ra0sms/civ2bcd/docs/pinout_v003f4.png

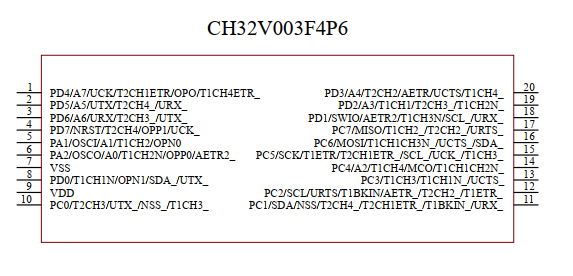
docs/pinout_v003f4.png
