ra0sms/civ2bcd/KiCad/civ2bcd/civ2bcd.pdf

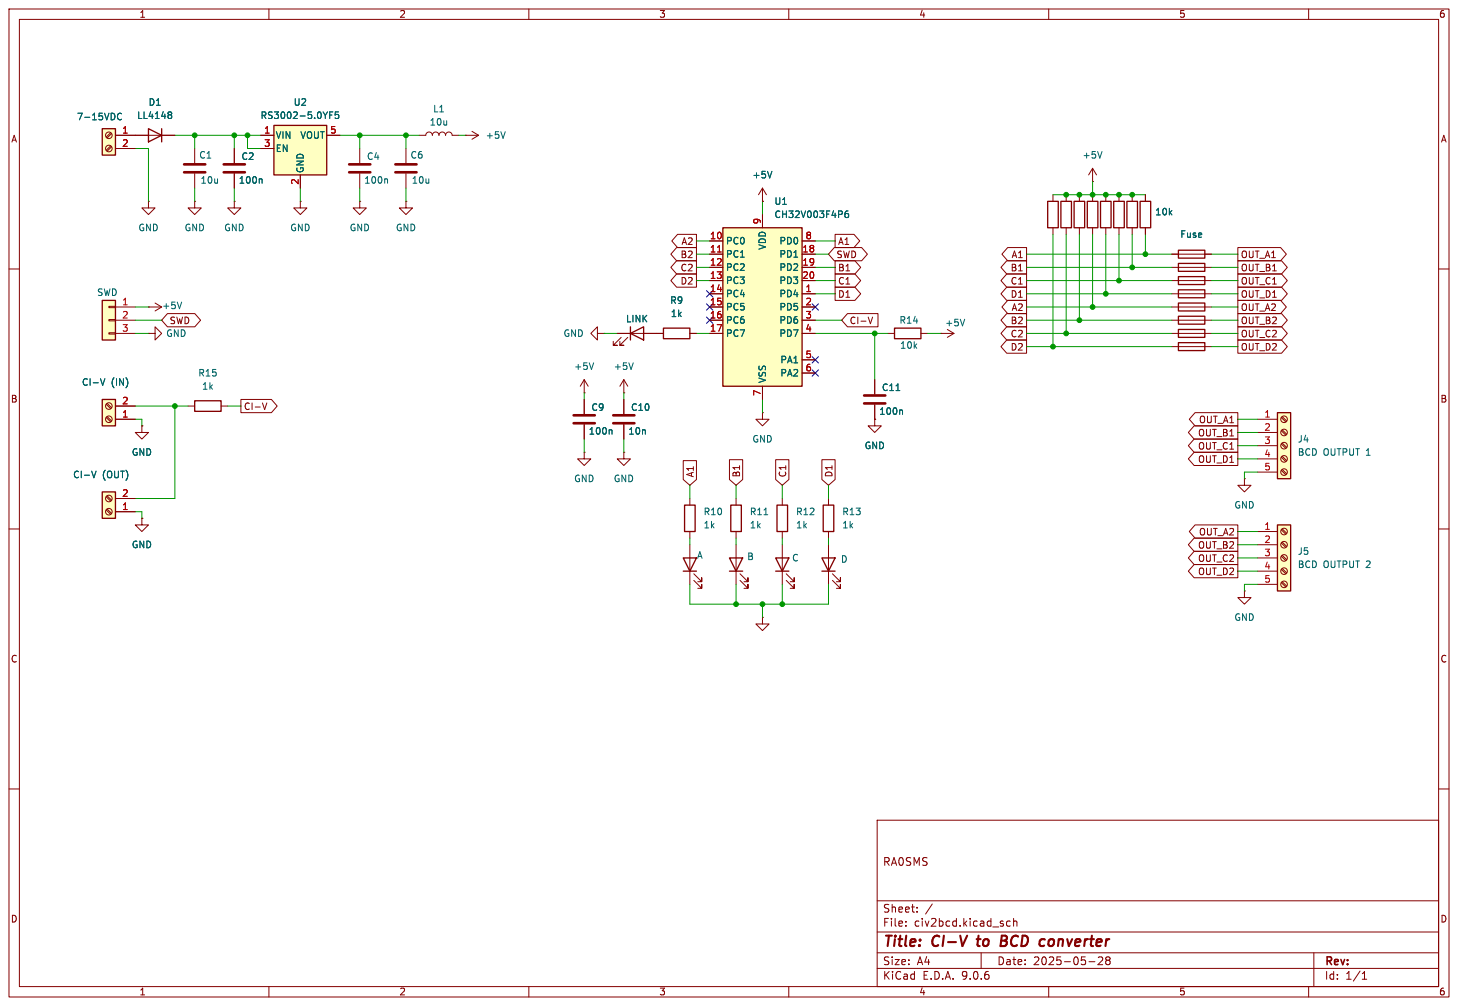
[picture p4: page 1]

Id: 1/1 Title: CI-V to BCD converter File: civ2bcd.kicad_sch Sheet: / RA0SMS
