ra0sms/civ2bcd/KiCad/civ2bcd/civ2bcd.kicad_pcb

## KiCad design KiCad/civ2bcd/civ2bcd.kicad_pcb (2026-01-14)

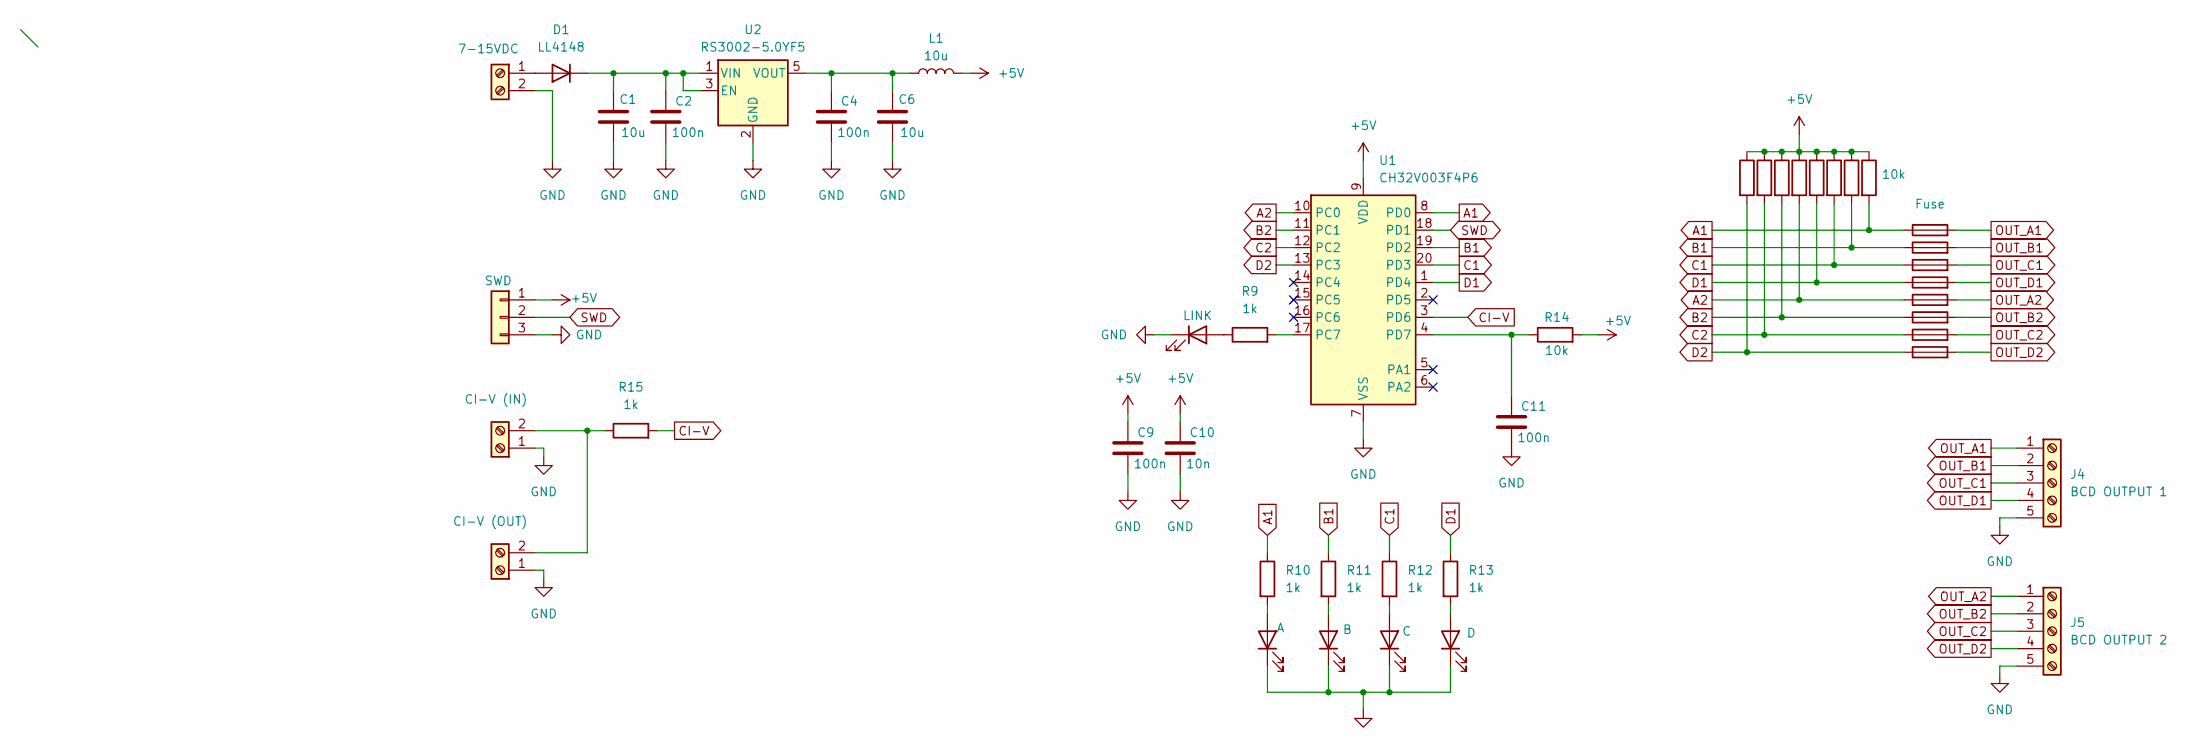
[picture p5: schematic civ2bcd.kicad_sch, CI-V to BCD converter]

Parts:
C1, C6: 10u; C_1206_3216Metric_Pad1.33x1.80mm_HandSolder
C2, C4, C9, C11: 100n; C_1206_3216Metric_Pad1.33x1.80mm_HandSolder
C10: 10n; C_1206_3216Metric_Pad1.33x1.80mm_HandSolder
D1: LL4148; D_MiniMELF
D2: LINK; LED_1206_3216Metric
D3: A; LED_1206_3216Metric
D4: B; LED_1206_3216Metric
D5: C; LED_1206_3216Metric
D6: D; LED_1206_3216Metric
F1, F2, F3, F4, F5, F6, F7, F8: Fuse; R_1206_3216Metric
J1: 7-15VDC; TerminalBlock_MetzConnect_Type055_RT01502HDWU_1x02_P5.00mm_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
J2: CI-V (OUT); TerminalBlock_MetzConnect_Type055_RT01502HDWU_1x02_P5.00mm_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
J3: SWD; PinSocket_1x03_P2.54mm_Vertical
J4: BCD OUTPUT 1; TerminalBlock_MetzConnect_Type011_RT05505HBLC_1x05_P5.00mm_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
J5: BCD OUTPUT 2; TerminalBlock_MetzConnect_Type011_RT05505HBLC_1x05_P5.00mm_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
J6: CI-V (IN); TerminalBlock_MetzConnect_Type055_RT01502HDWU_1x02_P5.00mm_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
L1: 10u; L_1206_3216Metric
R5, R6, R7, R8, R14, R19, R20, R21, R22: 10k; R_1206_3216Metric
R9, R10, R11, R12, R13, R15: 1k; R_1206_3216Metric
U1: CH32V003F4P6; TSSOP-20_4.4x6.5mm_P0.65mm
U2: RS3002-5.0YF5; SOT-23-5

Connections:
+5V: C9.1, C10.1, J3.1, L1.2, R5.1, R6.1, R7.1, R8.1, R14.2, R19.1, R20.1, R21.1, R22.1, U1.9 (VDD)
A1: F1.1, R5.2, R10.1, U1.8 (PD0)
A2: F5.1, R19.2, U1.10 (PC0)
B1: F2.1, R6.2, R11.1, U1.19 (PD2)
B2: F6.1, R20.2, U1.11 (PC1)
C1: F3.1, R7.2, R12.1, U1.20 (PD3)
C2: F7.1, R21.2, U1.12 (PC2)
CI-V: R15.2, U1.3 (PD6)
D1: F4.1, R8.2, R13.1, U1.1 (PD4)
D2: F8.1, R22.2, U1.13 (PC3)
GND: C1.2, C2.2, C4.2, C6.2, C9.2, C10.2, C11.2, D2.1 (K), D3.1 (K), D4.1 (K), D5.1 (K), D6.1 (K), J1.2, J2.1, J3.3, J4.5, J5.5, J6.1, U1.7 (VSS), U2.2 (GND)
unnamed: D1.2 (A), J1.1
unnamed: C1.1, C2.1, D1.1 (K), U2.1 (VIN), U2.3 (EN)
unnamed: D2.2 (A), R9.1
unnamed: D3.2 (A), R10.2
unnamed: D4.2 (A), R11.2
unnamed: D5.2 (A), R12.2
unnamed: D6.2 (A), R13.2
unnamed: J2.2, J6.2, R15.1
unnamed: R9.2, U1.17 (PC7)
unnamed: C11.1, R14.1, U1.4 (PD7)
unnamed: C4.1, C6.1, L1.1, U2.5 (VOUT)
OUT_A1: F1.2, J4.1
OUT_A2: F5.2, J5.1
OUT_B1: F2.2, J4.2
OUT_B2: F6.2, J5.2
OUT_C1: F3.2, J4.3
OUT_C2: F7.2, J5.3
OUT_D1: F4.2, J4.4
OUT_D2: F8.2, J5.4
SWD: J3.2, U1.18 (PD1)

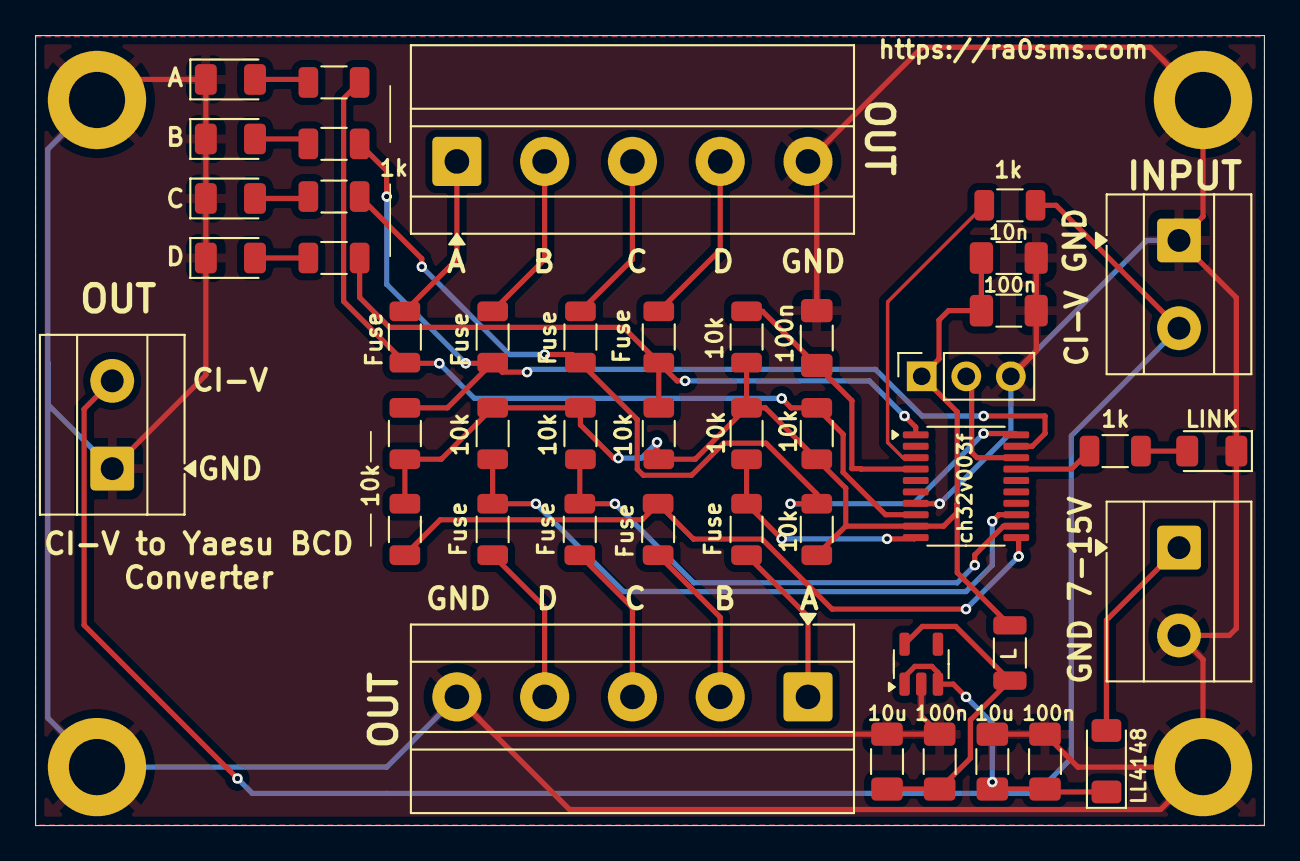
[picture p6: board civ2bcd.kicad_pcb from above]

Board: 2 copper layers, 70.0 x 45.0 mm, 45 parts (0 on the bottom side), 31 nets.
