ra0sms/civ2bcd/code/civ2bcd/User/main.h

#include "debug.h"

#define BAUD_RATE 9600

#define LED_Pin GPIO_Pin_7
#define LED_GPIO_Port GPIOC
//**************
#define OUT_A1 GPIO_Pin_0
#define OUT_A1_Port GPIOD
//***************
#define OUT_B1 GPIO_Pin_2
#define OUT_B1_Port GPIOD
//***************
#define OUT_C1 GPIO_Pin_3
#define OUT_C1_Port GPIOD
//***************
#define OUT_D1 GPIO_Pin_4
#define OUT_D1_Port GPIOD
//**************
#define OUT_A2 GPIO_Pin_0
#define OUT_A2_Port GPIOC
//***************
#define OUT_B2 GPIO_Pin_1
#define OUT_B2_Port GPIOC
//***************
#define OUT_C2 GPIO_Pin_2
#define OUT_C2_Port GPIOC
//***************
#define OUT_D2 GPIO_Pin_3
#define OUT_D2_Port GPIOC
//**************
