ra0sms/civ2bcd/(commit log)

2025-12-15 fix issues with civ input
    [civ2bcd-B_Cu.gbr, civ2bcd-B_Mask.gbr, civ2bcd-B_Paste.gbr, civ2bcd-B_Silkscreen.gbr, civ2bcd-Edge_Cuts.gbr, civ2bcd-F_Cu.gbr, civ2bcd-F_Mask.gbr, civ2bcd-F_Paste.gbr]
2026-01-14 fix civ connection
    [civ2bcd-B_Cu.gbr, civ2bcd-B_Mask.gbr, civ2bcd-B_Paste.gbr, civ2bcd-B_Silkscreen.gbr, civ2bcd-Edge_Cuts.gbr, civ2bcd-F_Cu.gbr, civ2bcd-F_Mask.gbr, civ2bcd-F_Paste.gbr]
